Sean3Don/SmartTracker/Solidworks Parts/Antenna Tracker.SLDASM

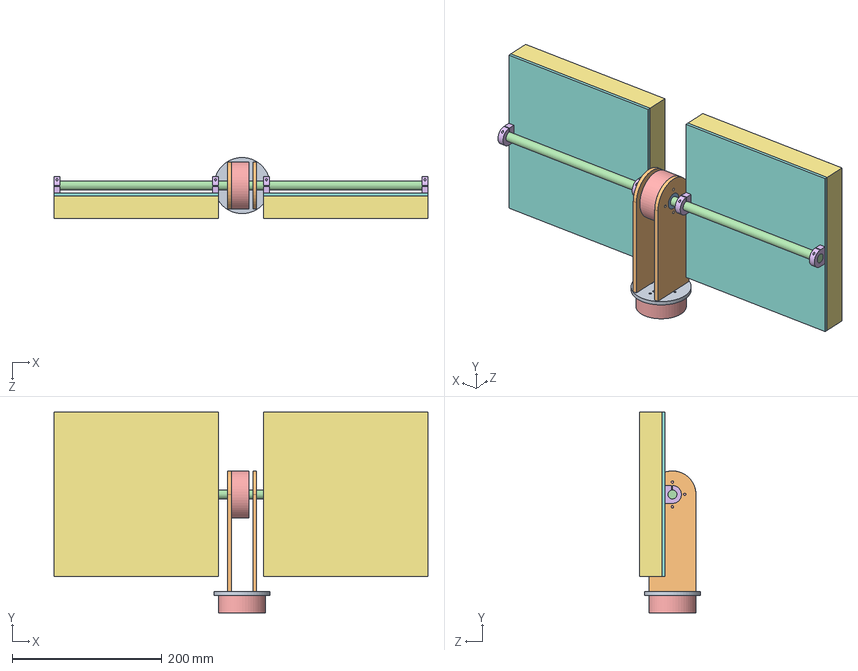
[picture p1: CAD file, 2015-03-30]
Solidworks Parts/Antenna Tracker.SLDASM
500.0 x 268.3 x 81.5 mm
Azimuth Base
Azimuth Mast x 2
Bearing x 2
Elevation Shaft
Shaft Clamp x 4
Patch Antenna x 2
Patch Antenna Mount x 2
