Sean3Don/SmartTracker/Solidworks Parts/Azimuth Base.SLDPRT

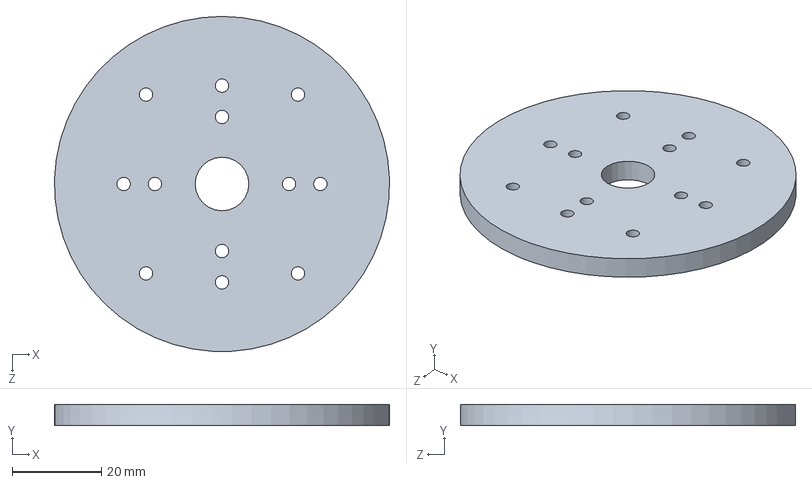
[picture p2: CAD file, 2015-03-30]
Solidworks Parts/Azimuth Base.SLDPRT
75.0 x 4.76 x 75.0 mm
