Sean3Don/SmartTracker/Solidworks Parts/Elevation Shaft.SLDPRT

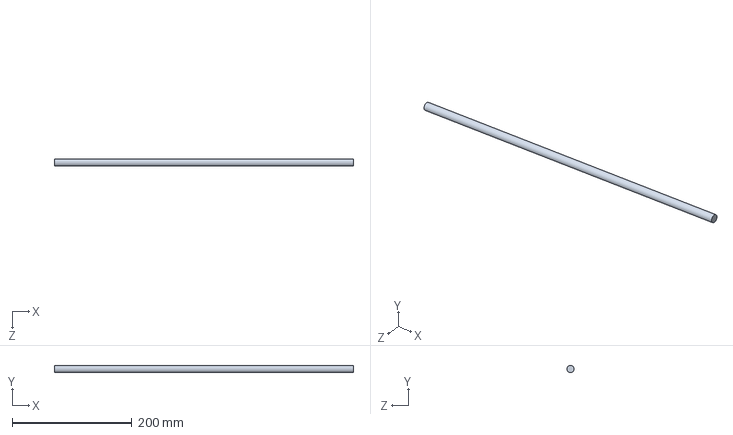
[picture p3: CAD file, 2015-03-30]
Solidworks Parts/Elevation Shaft.SLDPRT
500.0 x 12.0 x 12.0 mm
