Sean3Don/SmartTracker/Solidworks Parts/Patch Antenna Mount.SLDPRT

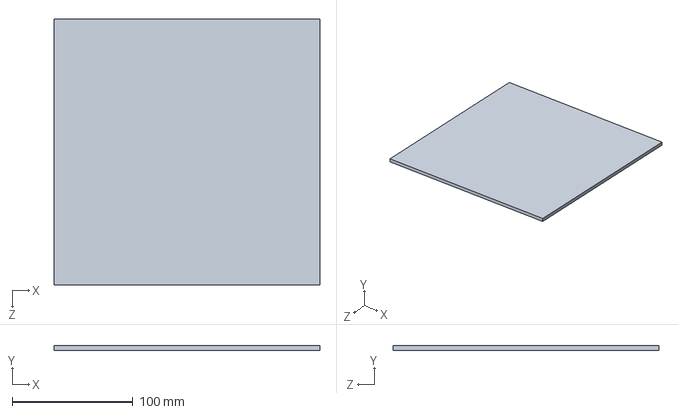
[picture p4: CAD file, 2015-03-30]
Solidworks Parts/Patch Antenna Mount.SLDPRT
220.0 x 4.00 x 220.0 mm
