Sean3Don/SmartTracker/Solidworks Parts/Patch Antenna.SLDPRT

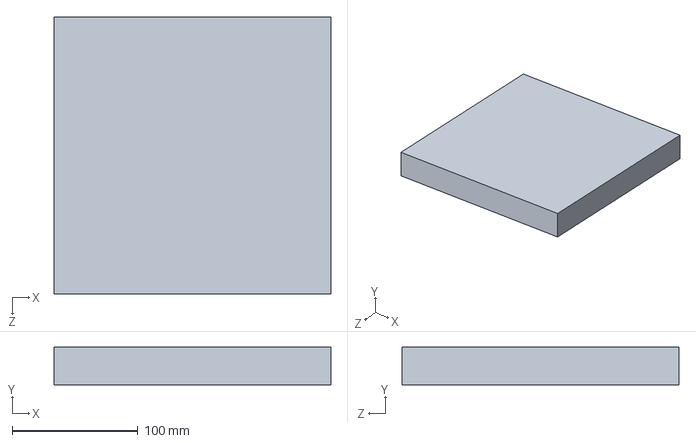
[picture p5: CAD file, 2015-03-30]
Solidworks Parts/Patch Antenna.SLDPRT
220.0 x 30.0 x 220.0 mm
