Sean3Don/SmartTracker/Solidworks Parts/Shaft Clamp.SLDPRT

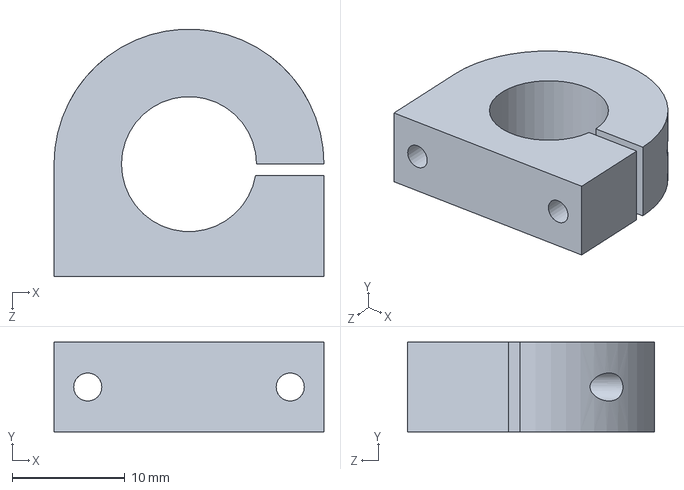
[picture p6: CAD file, 2015-03-30]
Solidworks Parts/Shaft Clamp.SLDPRT
24.0 x 8.00 x 22.0 mm
