Sean3Don/SmartTracker/Solidworks Parts/Azimuth Mast.SLDPRT

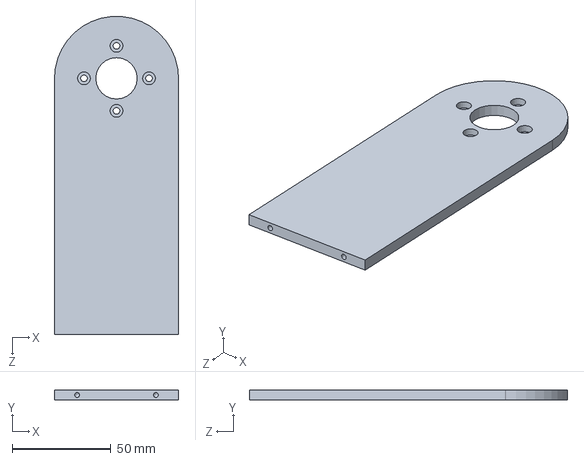
[picture p7: CAD file, 2015-03-30]
Solidworks Parts/Azimuth Mast.SLDPRT
63.0 x 5.00 x 161.4 mm
