Sean3Don/SmartTracker/Solidworks Parts/5208_200.SLDPRT

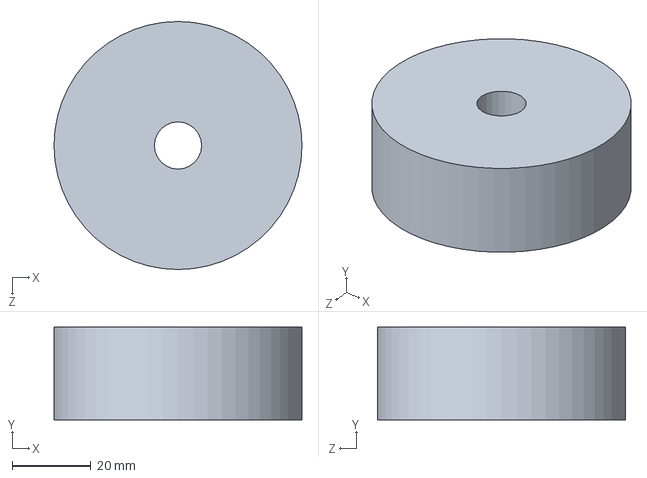
[picture p8: CAD file, 2015-03-30]
Solidworks Parts/5208_200.SLDPRT
63.0 x 23.5 x 63.0 mm
