Sean3Don/SmartTracker/Solidworks Parts/Bearing.SLDPRT

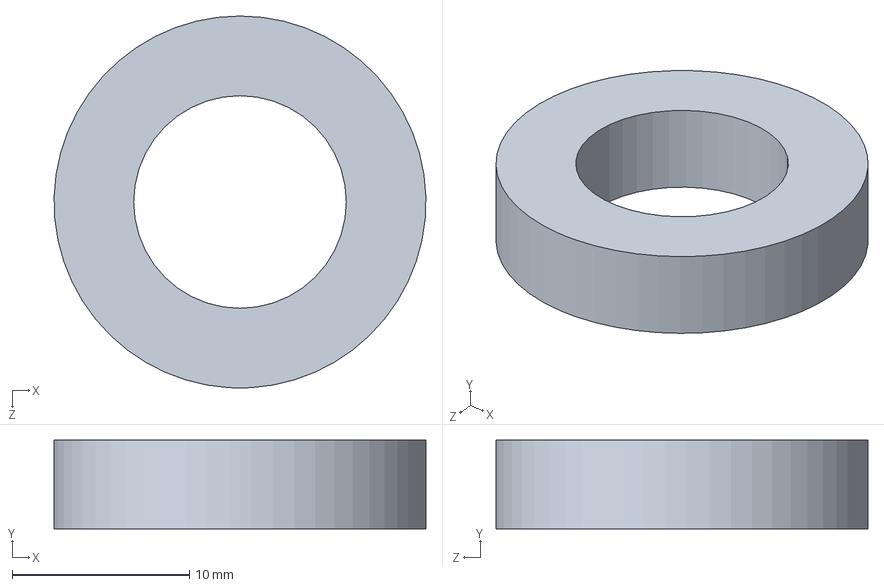
[picture p9: CAD file, 2015-03-30]
Solidworks Parts/Bearing.SLDPRT
21.0 x 5.00 x 21.0 mm
