Sean3Don/SmartTracker/Eagle Files/antenna_tracker.brd

## EAGLE design Eagle Files/antenna_tracker.brd (2014-08-04)

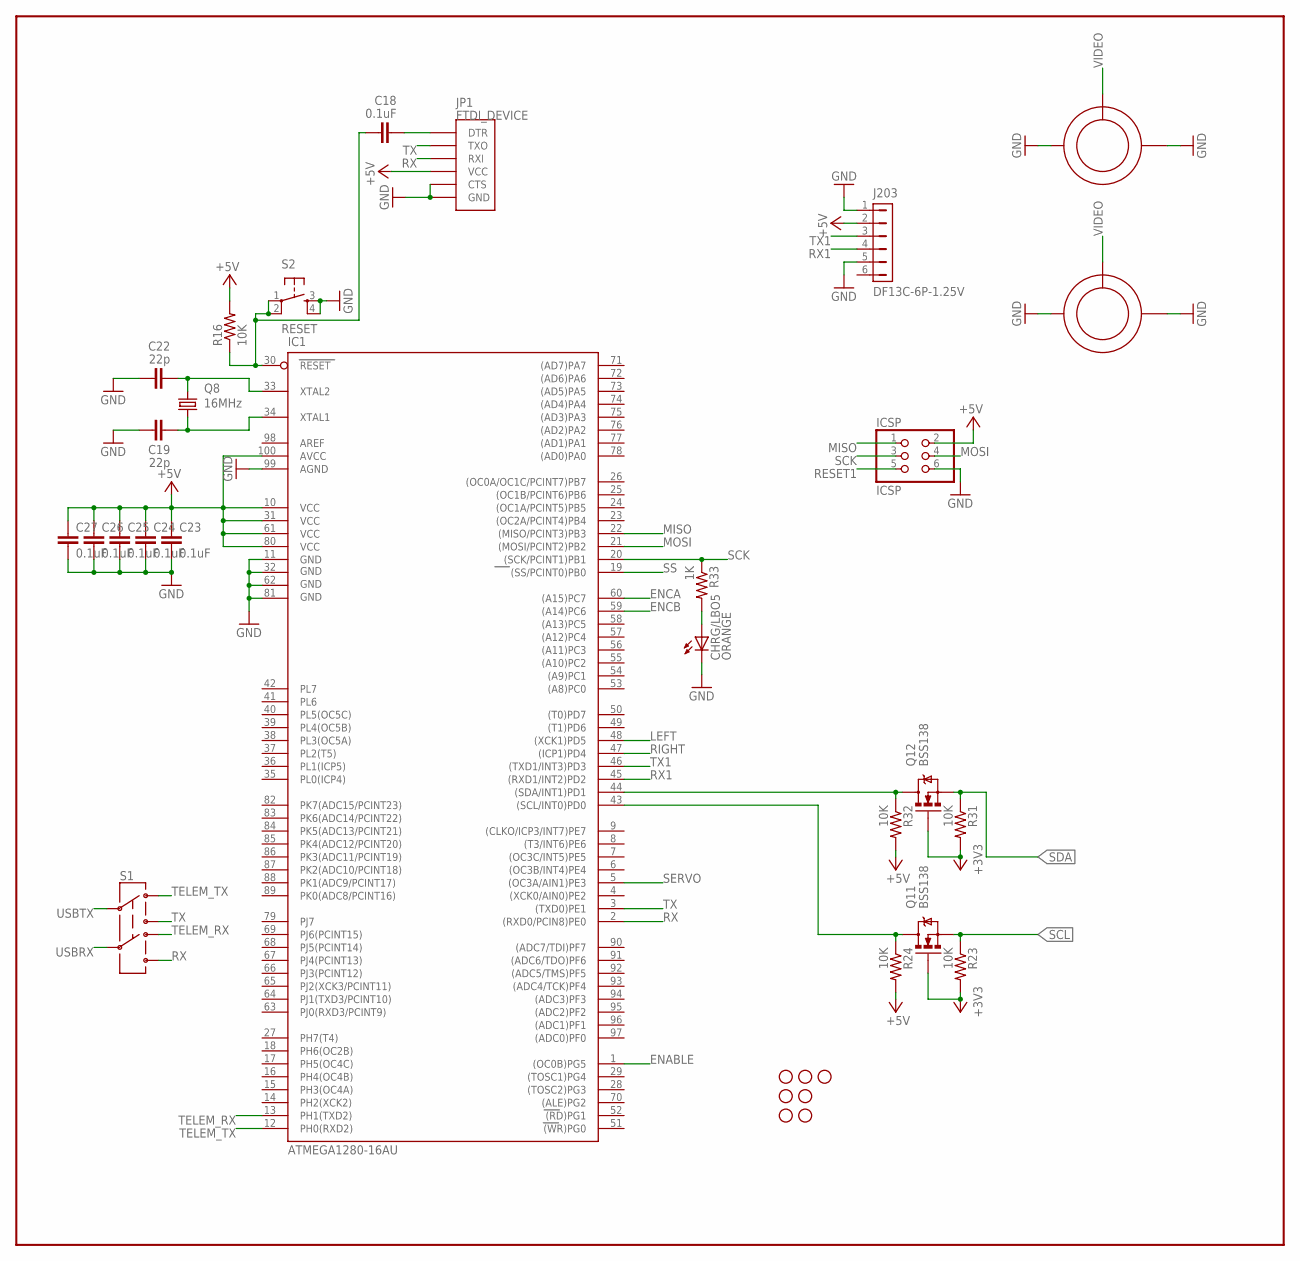
[picture p10: schematic antenna_tracker.sch, sheet 1]

Parts:
C18, C23, C24, C25, C26, C27: 0.1uF; C0603K; PARTNO GRM188R71E104KA01D
C19, C22: 22p; C0603K; PARTNO C0805C220J5GACTU
CHRG/LBO5: ORANGE; CHIP-LED0805; PARTNO APT2012SECK
IC1: ATMEGA1280-16AU; TQFP100
ICSP: ICSP; 2X03; PARTNO PPTC032LFBN-RC
J203: DF13C-6P-1.25V; PARTNO DF13C-6P-1.25V(20)
JP1: FTDI_DEVICE; FTDI_DEVICE_SIDE; PARTNO PREC040SFAN-RC
Q8: 16MHz; HC49/S; PARTNO ATS16B
Q11, Q12: BSS138; SOT23-3; PARTNO BSS138
R16, R23, R24, R31, R32: 10K; R0805; PARTNO 1623097-1
R33: 1K; M0805; PARTNO RMCF0805JT1K00
S1: SWITCH-DPDTPTH; MSS22; PARTNO 1825261-2
S2: RESET; TACTILE-PTH; PARTNO 1825910-6
STANDOFF1, STANDOFF2, STANDOFF3, STANDOFF4, STANDOFF5, STANDOFF6, STANDOFF7: STAND-OFF
U$10, U$11: RCA_VERTICAL; PARTNO RCJ-021

Connections:
+3V3: Q11.1 (G), Q12.1 (G), R23.2, R31.2; also elsewhere on the board
+5V: C23.1, C24.1, C25.1, C26.1, C27.1, IC1.10 (VCC), IC1.31 (VCC1), IC1.61 (VCC2), IC1.80 (VCC3), IC1.100 (AVCC), ICSP.2, J203.2, JP1.P$4 (VCC), R16.2, R24.2, R32.2; also elsewhere on the board
ENABLE: IC1.1 ((OC0B)PG5); also elsewhere on the board
ENCA: IC1.60 ((A15)PC7); also elsewhere on the board
ENCB: IC1.59 ((A14)PC6); also elsewhere on the board
GND: C19.1, C22.1, C23.2, C24.2, C25.2, C26.2, C27.2, CHRG/LBO5.C, IC1.11 (GND), IC1.32 (GND1), IC1.62 (GND2), IC1.81 (GND3), IC1.99 (AGND), ICSP.6, J203.1, J203.5, JP1.P$5 (CTS), JP1.P$6 (GND), S2.3, S2.4, U$10.P$1 (GND), U$10.P$2 (GND), U$11.P$1 (GND), U$11.P$2 (GND); also elsewhere on the board
LEFT: IC1.48 ((XCK1)PD5); also elsewhere on the board
MISO: IC1.22 ((MISO/PCINT3)PB3), ICSP.1
MOSI: IC1.21 ((MOSI/PCINT2)PB2), ICSP.4
unnamed: C18.2, JP1.P$1 (DTR)
unnamed: C19.2, IC1.34 (XTAL1), Q8.1
unnamed: C22.2, IC1.33 (XTAL2), Q8.2
unnamed: IC1.44 ((SDA/INT1)PD1), Q12.3 (D), R32.1
unnamed: IC1.43 ((SCL/INT0)PD0), Q11.3 (D), R24.1
unnamed: CHRG/LBO5.A, R33.2
RESET1: C18.1, IC1.30 (RESET), ICSP.5, R16.1, S2.1, S2.2
RIGHT: IC1.47 ((ICP1)PD4); also elsewhere on the board
RX: IC1.2 ((RXD0/PCIN8)PE0), JP1.P$3 (RXI), S1.6
RX1: IC1.45 ((RXD1/INT2)PD2), J203.4
SCK: IC1.20 ((SCK/PCINT1)PB1), ICSP.3, R33.1
SCL: Q11.2 (S), R23.1; also elsewhere on the board
SDA: Q12.2 (S), R31.1; also elsewhere on the board
SERVO: IC1.5 ((OC3A/AIN1)PE3); also elsewhere on the board
SS: IC1.19 ((SS/PCINT0)PB0)
TELEM_RX: IC1.13 (PH1(TXD2)), S1.4; also elsewhere on the board
TELEM_TX: IC1.12 (PH0(RXD2)), S1.1; also elsewhere on the board
TX: IC1.3 ((TXD0)PE1), JP1.P$2 (TXO), S1.3
TX1: IC1.46 ((TXD1/INT3)PD3), J203.3
USBRX: S1.5; also elsewhere on the board
USBTX: S1.2; also elsewhere on the board
VIDEO: U$10.P$3 (SIGNAL), U$11.P$3 (SIGNAL); also elsewhere on the board

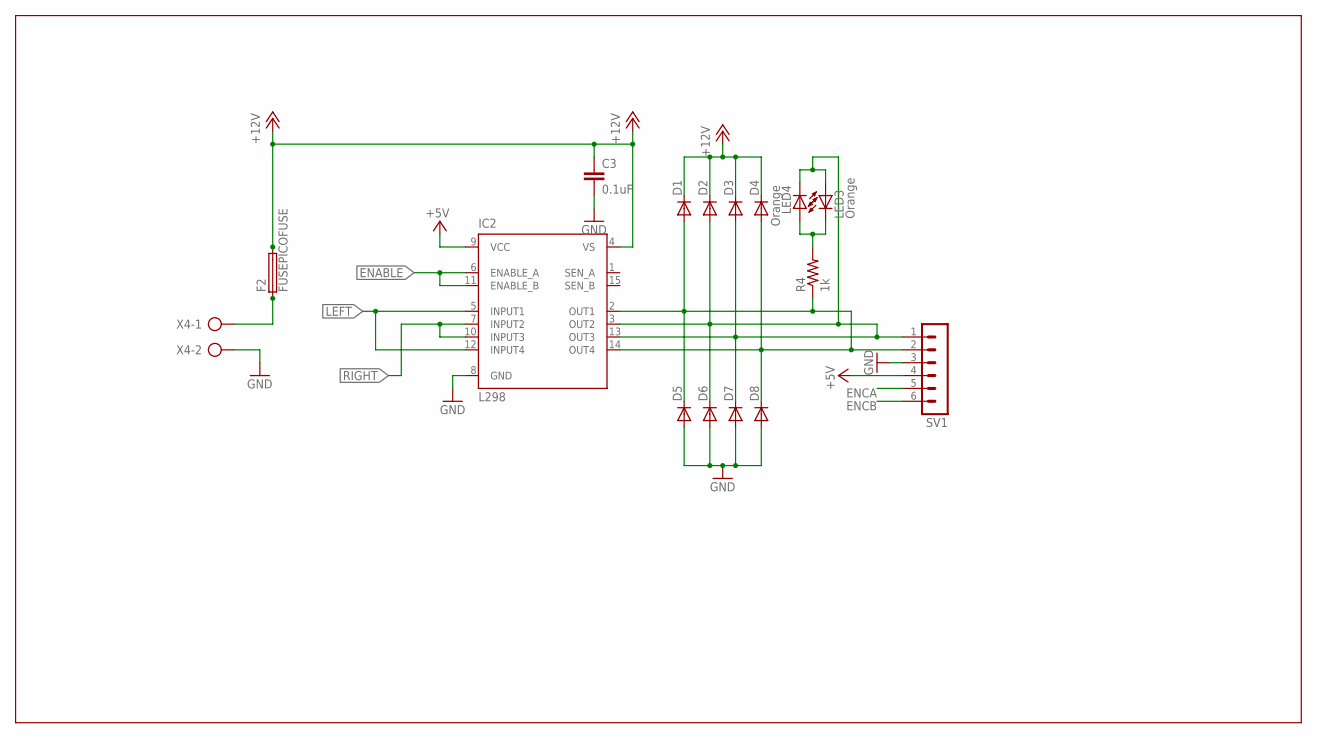
[picture p11: schematic antenna_tracker.sch, sheet 2]

Parts:
C3: 0.1uF; 0603-CAP; PARTNO GRM188R71E104KA01D
D1, D2, D3, D4, D5, D6, D7, D8: DIODE-DO214AC; DO214AC; PARTNO ES2B-LTP
F2: FUSEPICOFUSE; PICOFUSE; PARTNO RUEF700-2
IC2: L298; MULTIWATT-15
LED3, LED4: Orange; SML0805; PARTNO APT2012SECK
R4: 1k; R0805; PARTNO RMCF0805JT1K00
SV1: MA06-1; PARTNO PREC040SFAN-RC
X4: AK300/2; PARTNO OSTTC022162

Connections:
+5V: IC2.9 (VCC), SV1.4; also elsewhere on the board
+12V: C3.1, D1.C, D2.C, D3.C, D4.C, F2.2, IC2.4 (VS); also elsewhere on the board
ENABLE: IC2.6 (ENABLE_A), IC2.11 (ENABLE_B); also elsewhere on the board
ENCA: SV1.5; also elsewhere on the board
ENCB: SV1.6; also elsewhere on the board
GND: C3.2, D5.A, D6.A, D7.A, D8.A, IC2.8 (GND), SV1.3, X4.2; also elsewhere on the board
LEFT: IC2.5 (INPUT1), IC2.12 (INPUT4); also elsewhere on the board
unnamed: D2.A, D3.A, D6.C, D7.C, IC2.3 (OUT2), IC2.13 (OUT3), LED3.A, LED4.C, SV1.1
unnamed: D1.A, D4.A, D5.C, D8.C, IC2.2 (OUT1), IC2.14 (OUT4), R4.1, SV1.2
unnamed: LED3.C, LED4.A, R4.2
unnamed: F2.1, X4.1
RIGHT: IC2.7 (INPUT2), IC2.10 (INPUT3); also elsewhere on the board

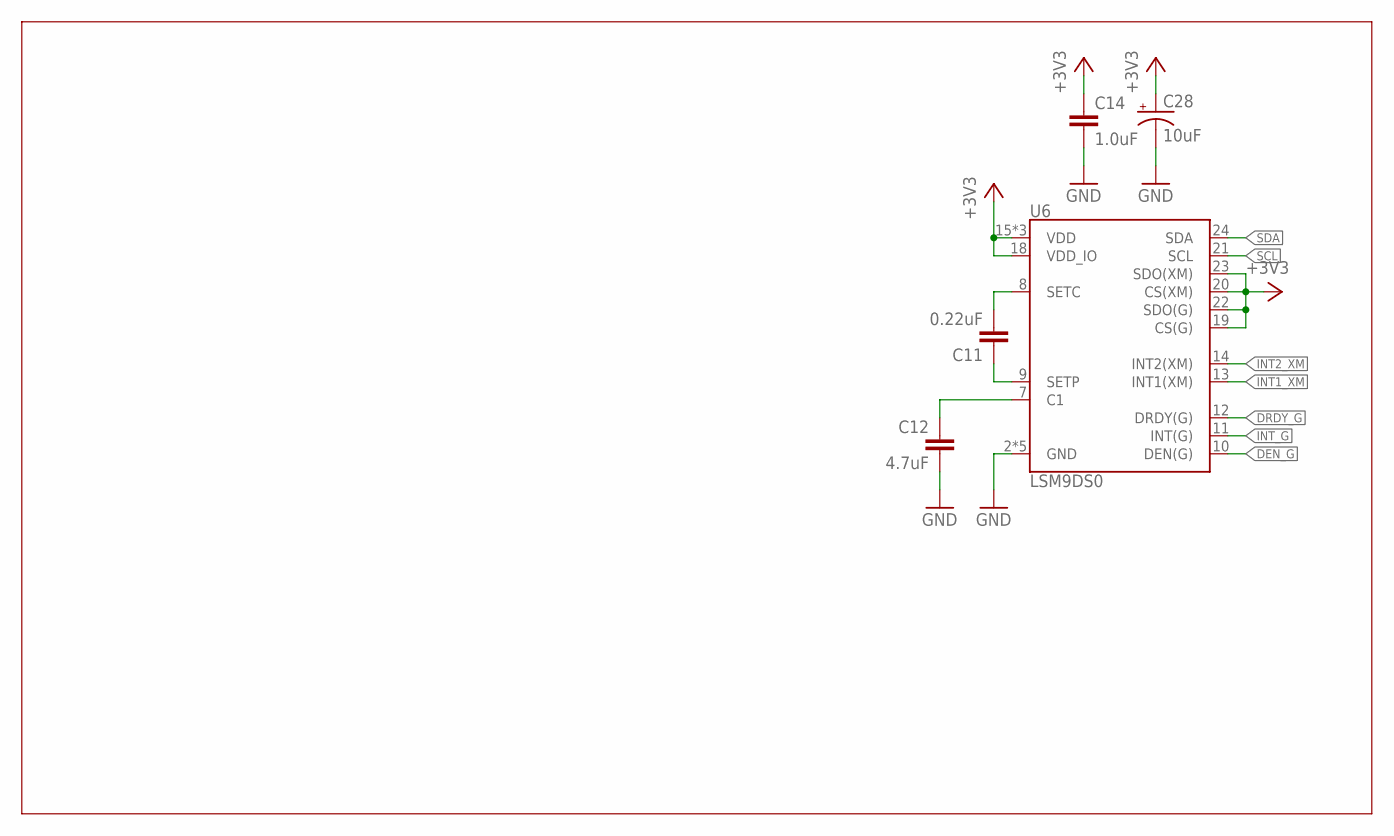
[picture p12: schematic antenna_tracker.sch, sheet 3]

Parts:
C11: 0.22uF; 0603-CAP; PARTNO CL10B224KA8NNNC
C12: 4.7uF; 0603-CAP; PARTNO CL10B475KQ8NQNC
C14: 1.0uF; 0603-CAP; PARTNO C0603C105K8PACTU
C28: 10uF; EIA3216; PARTNO EEE-1CA100SR
U6: LSM9DS0; LGA-24

Connections:
+3V3: C14.1, C28.A (+), U6.15 (VDD), U6.16 (VDD), U6.17 (VDD), U6.18 (VDD_IO), U6.19 (CS(G)), U6.20 (CS(XM)), U6.22 (SDO(G)), U6.23 (SDO(XM)); also elsewhere on the board
DEN_G: U6.10 (DEN(G))
DRDY_G: U6.12 (DRDY(G))
GND: C12.2, C14.2, C28.C (-), U6.2 (GND), U6.3 (GND), U6.4 (GND), U6.5 (GND), U6.6 (GND); also elsewhere on the board
INT1_XM: U6.13 (INT1(XM))
INT2_XM: U6.14 (INT2(XM))
INT_G: U6.11 (INT(G))
unnamed: C11.1, U6.9 (SETP)
unnamed: C11.2, U6.8 (SETC)
unnamed: C12.1, U6.7 (C1)
SCL: U6.21 (SCL); also elsewhere on the board
SDA: U6.24 (SDA); also elsewhere on the board

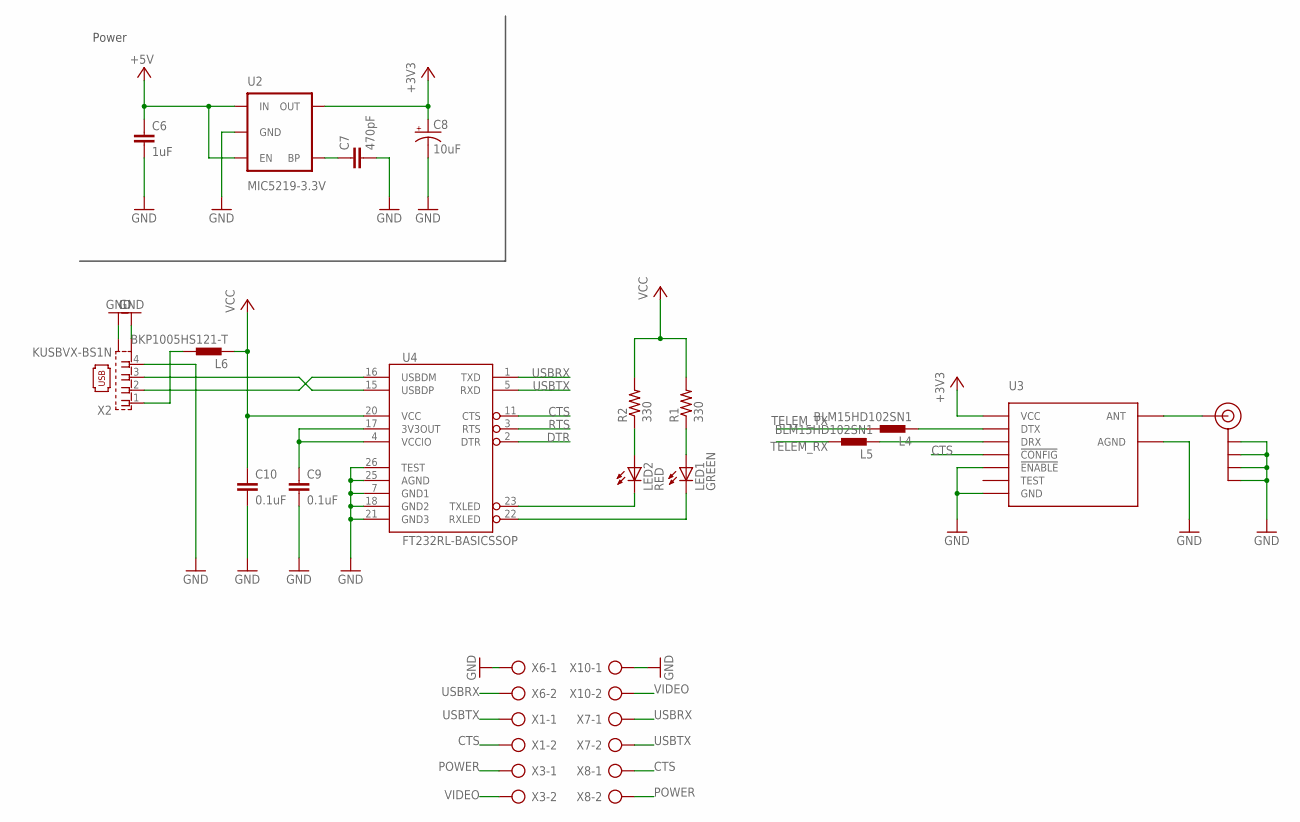
[picture p13: schematic antenna_tracker.sch, sheet 4]

Parts:
C6: 1uF; 0402-CAP; PARTNO C0603C105K8PACTU
C7: 470pF; 0402-CAP; PARTNO GRM1555C1H471JA01D
C8: 10uF; EIA3216; PARTNO EEE-1CA100SR
C9, C10: 0.1uF; C0603K; PARTNO GRM188R71E104KA01D
J$1: SMA_EDGE; SMA-EDGE; PARTNO 0732511150
L4, L5: BLM15HD102SN1; 0402-IND; PARTNO BLM15HD102SN1D
L6: BKP1005HS121-T; 0402-IND; PARTNO BKP1005HS121-T
LED1: GREEN; CHIP-LED0805; PARTNO LG R971-KN-1
LED2: RED; CHIP-LED0805; PARTNO LH R974-LP-1
R1, R2: 330; 0402-RES; PARTNO MCR01MRTF3300
U2: MIC5219-3.3V; SOT23-5; PARTNO MIC5219-3.3YM5 TR
U3: HM-TRPSMD; HM-TRP-SMD
U4: FT232RL-BASICSSOP; SSOP28DB; PARTNO FT232RL-REEL
X1, X3, X6, X7, X8, X10: AK300/2; PARTNO OSTTC022162
X2: KUSBVX-BS1N; PARTNO 5787834-1

Connections:
+3V3: C8.A (+), U2.5 (OUT), U3.VCC; also elsewhere on the board
+5V: C6.1, U2.1 (IN), U2.3 (EN); also elsewhere on the board
CTS: U3.!CONFIG, U4.11 (CTS), X1.2, X8.1
DTR: U4.2 (DTR)
GND: C6.2, C7.2, C8.C (-), C9.2, C10.2, J$1.GND@0 (GND), J$1.GND@1 (GND), J$1.GND@2 (GND), J$1.GND@3 (GND), U2.2 (GND), U3.!ENABLE, U3.AGND, U3.GND, U4.7 (GND1), U4.18 (GND2), U4.21 (GND3), U4.25 (AGND), U4.26 (TEST), X2.4, X2.M1 (S1), X2.M2 (S2), X6.1, X10.1; also elsewhere on the board
unnamed: C7.1, U2.4 (BP)
unnamed: J$1.SIG (SIGNAL), U3.ANT
unnamed: C9.1, U4.4 (VCCIO), U4.17 (3V3OUT)
unnamed: U4.16 (USBDM), X2.2
unnamed: LED2.A, R2.1
unnamed: LED1.A, R1.1
unnamed: LED2.C, U4.23 (TXLED)
unnamed: LED1.C, U4.22 (RXLED)
unnamed: L4.P$2 (2), U3.DTX
unnamed: L5.P$2 (2), U3.DRX
unnamed: L6.P$1 (1), X2.1
unnamed: U4.15 (USBDP), X2.3
POWER: X3.1, X8.2
RTS: U4.3 (RTS)
TELEM_RX: L5.P$1 (1); also elsewhere on the board
TELEM_TX: L4.P$1 (1); also elsewhere on the board
USBRX: U4.1 (TXD), X6.2, X7.1; also elsewhere on the board
USBTX: U4.5 (RXD), X1.1, X7.2; also elsewhere on the board
VCC: C10.1, L6.P$2 (2), R1.2, R2.2, U4.20 (VCC)
VIDEO: X3.2, X10.2; also elsewhere on the board

Notes on the sheet:
Power

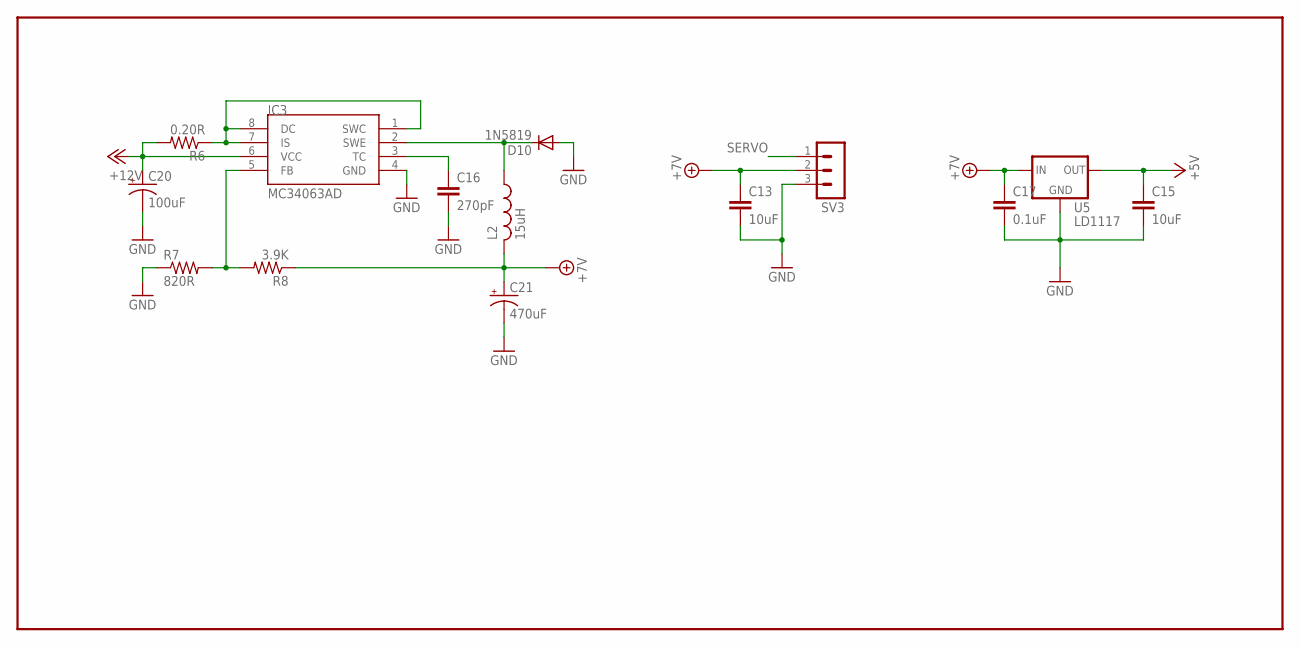
[picture p14: schematic antenna_tracker.sch, sheet 5]

Parts:
C13, C15: 10uF; C0805K; PARTNO CL21A106KAFN3NE
C16: 270pF; C0603K; PARTNO CC0603KRX7R9BB271
C17: 0.1uF; C0603K; PARTNO GRM188R71E104KA01D
C20: 100uF; E2,5-6E; PARTNO ESK107M025AE3AA
C21: 470uF; E3,5-8; PARTNO UVR1C471MPD
D10: 1N5819; SOD123; PARTNO 1N5819HW-7-F
IC3: MC34063AD; SOIC8; PARTNO MC34063ECD-TR
L2: 15uH; POWER-CHOKE_WE-TPC; PARTNO NR6028T150M
R6: 0.20R; R0603; PARTNO 73L2R20J
R7: 820R; R0603; PARTNO 1623097-1
R8: 3.9K; R0603; PARTNO RMCF0603JT3K90
SV3: MA03-1; PARTNO PREC040SFAN-RC
U5: LD1117; DPAK; PARTNO LD1117DT50CTR

Connections:
+5V: C15.1, U5.4 (OUT); also elsewhere on the board
+7V: C13.1, C17.1, C21.+, L2.2, R8.1, SV3.2, U5.3 (IN)
+12V: C20.+, IC3.6 (VCC), R6.2; also elsewhere on the board
GND: C13.2, C15.2, C16.2, C17.2, C20.-, C21.-, D10.A, IC3.4 (GND), R7.1, SV3.3, U5.1 (GND); also elsewhere on the board
unnamed: C16.1, IC3.3 (TC)
unnamed: IC3.1 (SWC), IC3.7 (IS), IC3.8 (DC), R6.1
unnamed: IC3.5 (FB), R7.2, R8.2
unnamed: D10.C, IC3.2 (SWE), L2.1
SERVO: SV3.1; also elsewhere on the board

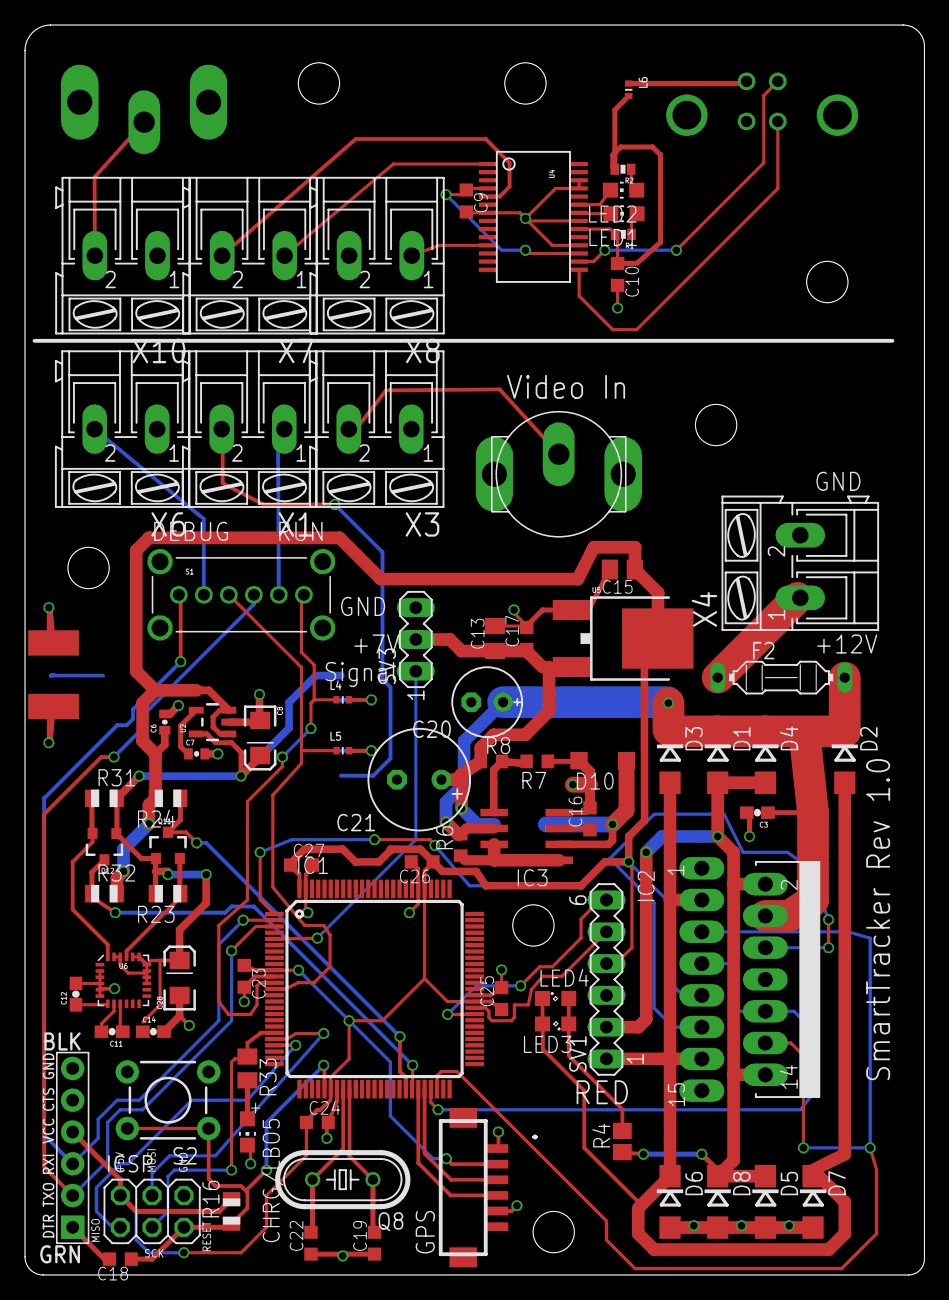
[picture p15: board antenna_tracker.brd from above]

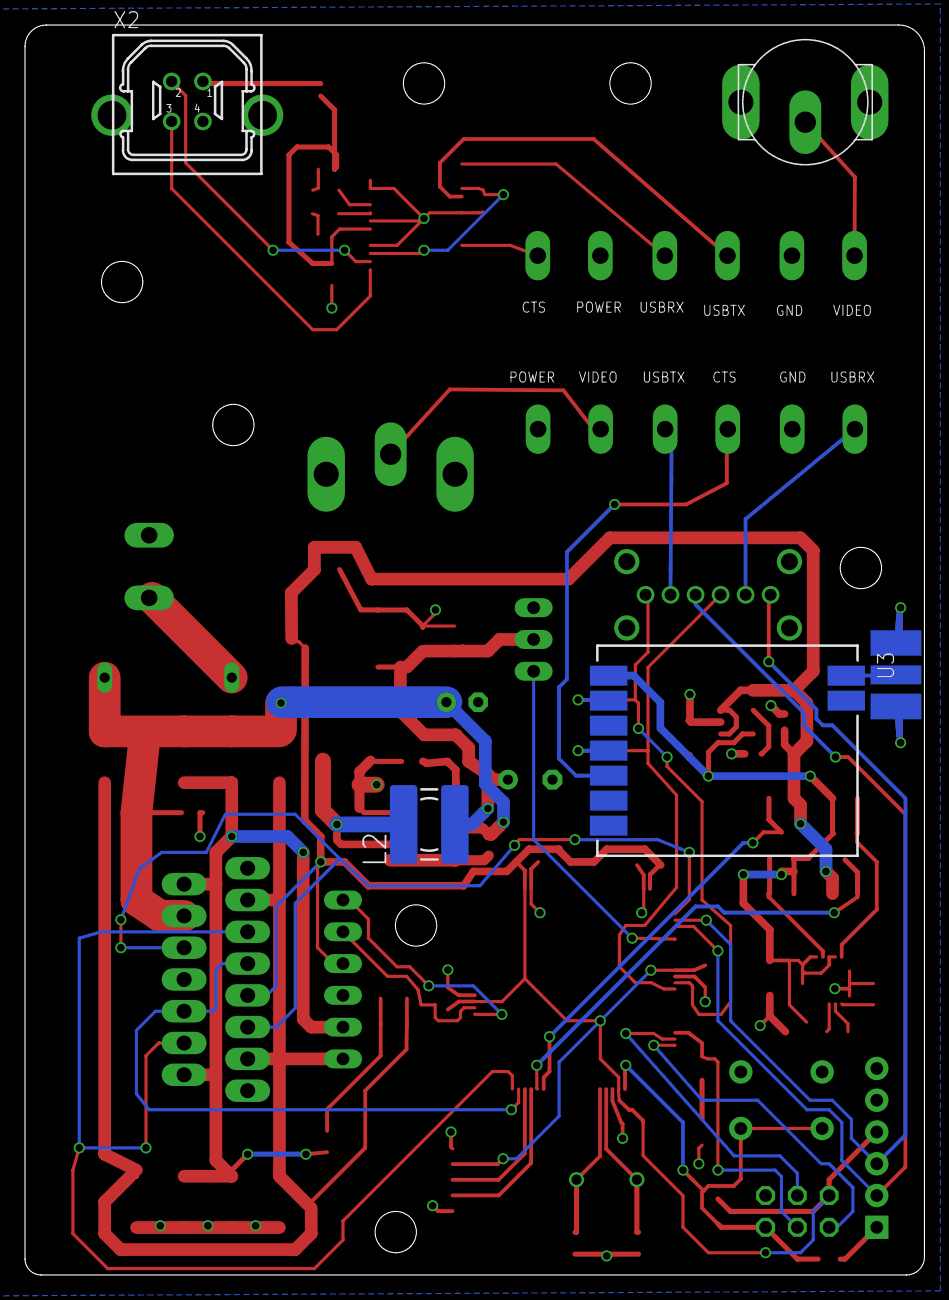
[picture p16: board antenna_tracker.brd from below]

Board: 4 copper layers, 71.9 x 99.9 mm, 91 parts (5 on the bottom side), 58 nets.
