Sean3Don/SmartTracker/SmartTracker/SmartTracker.ino

/*
 Copyright (c) 2013 Andy Little 

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
 You should have received a copy of the GNU General Public License
 along with this program. If not, see <http://www.gnu.org/licenses/>
*/

#include <Arduino.h>
#include <fifo.h>
#include <aircraft.h>
#include <mavlink.h>
#include <asynch_tx.h>
#include <frsky.h>
#include <math.h>

namespace {

   static const int HeartbeatLed = 13;
   double azimuth = 0;
   double inclination = 0;
   int homeLat = 0;
   int homeLon = 0;

   //static const int FrSkySPInvertSignal = 2;
   
   double getAzimuth()
   {
     int dlat = the_aircraft.location.gps_lat - homeLat;
     int dlon = the_aircraft.location.gps_lon - homeLon;
     return atan2(dlon, dlat);
   }
   
   double getInclination()
   {
     int dlat = the_aircraft.location.gps_lat - homeLat;
     int dlon = the_aircraft.location.gps_lon - homeLon;
     int angularDistance = sqrt(dlat^2 + dlon^2);
     int distance = ((6371*PI)/180)*angularDistance;
     return acos(the_aircraft.location.gps_lat/distance);
   }
   
   void setHome(){
     homeLat = the_aircraft.location.gps_lat;
     homeLon = the_aircraft.location.gps_lon;
   }

   void do_startup_leds(int n)
   {
        pinMode( HeartbeatLed, OUTPUT);   
        // do something to show we are starting up!
        for ( int i = 0; i < n; ++i){
           digitalWrite(HeartbeatLed,HIGH);
           delay(250);
           digitalWrite(HeartbeatLed,LOW);
           delay(250);
        }
   }


   void update_leds()
   {
      static unsigned long heartbeat_timer = 0;
      static uint32_t cur_num_heartbeats = 0;
      static bool heartbeat_led_on = false;
      uint32_t num_heartbeats = get_num_heartbeats();
      if ( num_heartbeats > cur_num_heartbeats){
         // new heartbeat
         cur_num_heartbeats = num_heartbeats;
         heartbeat_timer = millis();
         digitalWrite(HeartbeatLed,HIGH);
         heartbeat_led_on = true;
      }else{
         //turn off heartbeat led after a one shot pulse of 1/4 sec 
         if ( heartbeat_led_on && (( millis() - heartbeat_timer ) >= 250)){
           digitalWrite(HeartbeatLed,LOW);
           heartbeat_led_on = false;
         }
      }
   }
}

void setup()
{ 
  //pinMode(FrSkySPInvertSignal, INPUT);       
  //digitalWrite(FrSkySPInvertSignal, HIGH); // turn on internal pullup resistor
  do_startup_leds(10);
  cli();

  /*
   if the FrSkySPInvertSignal pin is pulled low then 
   invert the output serial transmitter signal.
   This is useful for the FrSky receiver which wants an inverted signal
*/
 
  //asynch_tx_setup(9600, !digitalRead(FrSkySPInvertSignal));
  //digitalWrite(FrSkySPInvertSignal, LOW);  // turn off internal pullup resistor to save a bit of power
  sei();
#if defined __AVR_ATmega32U4_
  Serial1.begin(57600); 
#else
  Serial2.begin(57600); 
#endif
Serial.begin(9600);
}


void loop()
{
   static unsigned long loop_time = 0;
   read_mavlink();

   if ( millis() - loop_time > 19){
      update_leds();
      loop_time = millis();
      
      Serial.println(the_aircraft.location.gps_lat);
      //FrSky_send_message();
   }
}
