Sean3Don/SmartTracker/(commit log)

2014-08-01 Eagle Files
    Added the .brd and .sch files for the controller
    [antenna_tracker.brd, antenna_tracker.sch]
2014-08-04 Switched to 9DOF IC and a new 7.2V Buck Convertor
    Added LSM9DS0 and MC34063
    [antenna_tracker.brd, antenna_tracker.sch]
2015-03-30 Added Solidworks Parts
    Added Solidworks parts and assembly
    [5208_200.SLDPRT, Antenna Tracker.SLDASM, Azimuth Base.SLDPRT, Azimuth Mast.SLDPRT, Bearing.SLDPRT, Elevation Shaft.SLDPRT, Patch Antenna Mount.SLDPRT, Patch Antenna.SLDPRT]
